bkammer/integrated_sensors_wise_22/README.md

# Integrated Sensors WS2022/23

## Messsystem Spektral-Sensor

Dokumentation: [Messsystem Spektral-Sensor](https://bkammer.github.io/integrated_sensors_wise_22/#/)

## Authors

- Yani Vutov
- Benjamin Kammer
- Dennis Spohrer
