bkammer/integrated_sensors_wise_22/docs/_coverpage.md

<!-- _coverpage.md -->



# Integrated Sensors <small>WS2022/23</small>

> Messsystem Spektral-Sensor

- Yani Vutov
- Benjamin Kammer
- Dennis Spohrer

[GitHub](https://github.com/bkammer/integrated_sensors_wise_22)
[Zur Dokumentation](#Integrated-Sensors)
