bkammer/integrated_sensors_wise_22/docs/_sidebar.md

<!-- files/_sidebar.md -->

* [**Home**](README.md)
* **Projektaufbau 1**
  * [Überblick](files/projektaufbau1.md)
* **Projektaufbau 2**
  * [Überblick](files/projektaufbau2.md)
  * [Stage 1](files/stage1.md)
  * [Stage 2](files/stage2.md)
  * [Stage 3](files/stage3.md)
* [**Offene Aufgaben**](files/offeneAufgaben.md)
* [**Nachwort**](files/nachwort.md)
* [**Quellen**](files/quellen.md)
