bkammer/integrated_sensors_wise_22/docs/files/nachwort.md

# Nachwort

Zusammenfassend, wir sind überzeugt, dass das Projekt ein voller Erfolg geworden ist.
Die selbst gesteckten Ziele konnten übertroffen werden.
Wir haben ein portables Messsystem in handlicher Form hergestellt.
Dieses System ermöglicht es uns, Messdaten von Objekten zu erfassen und diese durch einen Hotspot automatisiert an eine Datenbank in der Cloud zu schicken.
Diese Messdaten, welche das Lichtspektrum der Objekte beinhalten, können für den Benutzer jetzt schon visualisiert dargestellt werden!

Eine Weiterentwicklung des Projektes ist jederzeit möglich.
Es könnte eine automatisierte Analyse der Messdaten erstellt werden welche in ein Aktuatoriksystem zurückgespeist, beispielsweise unreife Bananen von reifen aussortiert.

Wir lernten im Team unsere Stärken zu nutzen und organisierten uns immer besser.
Wir konnten sehr viel über die Funktionsweise des Sensors lernen, als auch wie die Reflektrometrie funktioniert.
Außerdem haben wir neue Tools kennengelernt (z.B. Fusion360 für das Gehäuse, Docsify für die Erstellung von strukturierter Dokumentationen).
Das Arbeiten im Team wie auch das strukturierte, zielorientierte Arbeiten in diesem Projekt wird für unser Berufsleben als Software-Engineer sicherlich hilfreich sein.
