bkammer/integrated_sensors_wise_22/docs/files/offeneAufgaben.md

# Möglichkeiten der Weiterentwicklung

## Spektral-Sensor kalibrieren

Wir haben uns zu Beginn des Projektes überlegt, den Sensor zu mit definierten Farben zu kalibrieren.
Diese wären uns von Professor zur Verfügung gestellt worden, um z.B. zu messen, was "reines Weiß" für ein Spektrum besitzt.
Die gemessenen Daten sollten dann in ein eigenes Dashboard visualisiert werden, um damit z.B. Vergleiche mit anderen Messungen durchzuführen.

## Weitere Messsysteme aufbauen

Wir haben uns auch überlegt weitere Messsysteme aufzubauen, welche nicht innerhalb eines Stempels realisiert werden.
Für die gemessenen Daten müsste im Code eine neuer Tag erstellt werden, um die ESPs voneinander unterscheiden zu können.
Damit könnten die gemessenen Daten zwischen unterschiedlichen Messsystemen verglichen werden

## Eigenschaften ableiten

Eine weitere Möglichkeit wäre es aus den Datensätzen Eigenschaften zu erheben.
Damit könnten dann anschließend Aussagen über neue Messungen getroffen werden.
