bkammer/integrated_sensors_wise_22/docs/meetings/20221018.md

# 18. Oktober 2022

## AS7265x_Fragen_Pargmann

- Wo wird Spektrosopie eingesetzt?
- Brauchen wir Hintergrundwissen zur Spektroskopie?
- Welche Erfahrungen konnte er mit dem Sensor sammeln?
- Zu welchen Einsatzzwecken könnte der Sensor genutzt werden?
- Was ist möglich mit dem Sensor?
- Was kann man mit den 18 Kanälen messen?
- Messaufbau -> was muss beachtet werden? (Keine Lichteinstrahlung von außen?)
- Gibt es Grenzen was die Materialien angeht? (Flüssigkeiten, Gase, Feste Materialien. Messung von nicht hormogenen Materialien)
- Was für weitere Limitierungen hat der Sensor?
- Wie können die Daten interpretiert werden?
- Können mit den Datensätzen vergleiche mit anderen Datenbanken gemacht werden?
- Was für einen einfluss haben Lichtbrechung, Reflexion?
