bkammer/integrated_sensors_wise_22/docs/meetings/20221021.md

# Meeting 21. Oktober 2022

## Topics

- ESP Verbindungsaufbau mit Cloud InfluxDB
- Battery management system (BMS)
- Gehauseidee
- Batteriepower
  - Voltage Regulator
    - [Lipo Rider Plus](https://www.seeedstudio.com/Lipo-Rider-Plus-p-4204.html)
    - [ESP8266 Voltage Regulator](https://randomnerdtutorials.com/esp8266-voltage-regulator-lipo-and-li-ion-batteries/)
  - Build in Systems
    - [Adafruit HUZZAH32 - ESP32 Feather](https://learn.adafruit.com/adafruit-huzzah32-esp32-feather/power-management)
    - [SparkFun ESP32 Thing Plus](https://learn.sparkfun.com/tutorials/esp32-thing-plus-hookup-guide/all#hardware-overview)
    - [FireBeetle ESP32 IoT Microcontroller](https://www.dfrobot.com/product-1590.html)
- Battery
  - [Lithium Ion Battery - 1Ah](https://www.sparkfun.com/products/13813?_ga=2.225162522.1477246465.1666711157-1523142562.1666711157)
  - [Lithium Ion Battery - 1250mAh](https://www.sparkfun.com/products/18286)



## Topics ToDo

- [ ] Dennis: Grafana auf dem RaspberryPi aufsetzen. ESP32: Messung auf Knopfdruck ausfüren.
- [x] Ben: InfluxDB in der Cloud aufsetzen.
- [x] Yani: Einarbeitung in Fusion.
- [x] Marc fuer ESP32 und BMS Fragen.
  - Entweder ein BMS dazu kaufen + Batterie/Akku
  - oder neuen ESP32 mit BMS integriert + Batterie/Akku kaufen
- [x] Berenchen, wie viel Strom die Batterie zieht mit ESP + Sensor
- [ ] ESP in Sleep Modus schalten und per Knopfdruck wieder einschalten
- [ ] Beim Spektralsensor Lichter ausschalten
