bkammer/integrated_sensors_wise_22/docs/meetings/20221025.md

# Meeting 25. Oktober 2022

## Topics

- [x] Erstes Design des Gehäuses steht.
- [x] Datenbank läuft und erste Einrichtung des Nutzers, etc. von Dennis.
- [x] Grobe Rechnung des Stromverbrauches. 120 mA + 80 mA = 200 mA.
  - Batterie mit 800mAh reicht demnach für 4 Stunden.
- [ ] Eine LED als Statusanzeige verwenden, ob der ESP mit der Datenbank verbunden ist.
- Wartlick
  - [ ] Kontaktperson: Prof. König-Birk - Optik
  - [ ] Kontaktperson: Prof. Fittinghoff - Logistik Anwendung

## Topics ToDo

- Dennis: Setup ESP
- Brainstorming welche Materialien für die Messreihe verwendet werden sollen. (Bsp.: Papier)
- Testen von Grafana in der Cloud. (Ben)
- Yani: Anpassung des Gehäuses an den neuen ESP mit Akku
- Datenbank Schema überlegen.
- Prof. König-Birk ansprechen bezüglich Optik
- Prof. Fittinghoff ansprechen bezüglich Logistik Anwendung?

## Gespräch mit Mark

- Testen
  - Können alle Channels in die Datenbank geschickt werden?
  - Können die Daten wieder ausgelesen werden?
- 3D Drucker kann 1mm dicker - Sicherheitshalber auf 2 mm gehen.
- Montag (31.10.) ist Mark da um zu zeigen wie der Harz Drucker funktioniert.
- Proof of Concept abschließen um dann weitere Hardware bestellen zu können.
- Im Programm eine Flag einsetzen um die Debugging ausgabe am PC zu aktivieren/deaktivieren.
- Datenbankstruktur überprüfen lassen (falls andere Materialien gemessen werden sollen).
- Arbeiten mit einer Optik/Linse ist erst ein weiterer Step.
