bkammer/integrated_sensors_wise_22/docs/meetings/20221107.md

# Meeting 7. November 2022

## Topics

- [x] Gehäuse wurde gedruckt
- [x] Messvorgang implementiert

## ToDo

- Button spaming verhindern
- Button bouncing/prellen preventieren?
- Visualisierung der Daten
- Kalibrierung des Sensors
  - Termin mit Prof. Pargmann
