bkammer/integrated_sensors_wise_22/docs/meetings/20221111.md

# Meeting 11. November 2022

## Topics

- InfluxDB
  - [x] Daten persistiert
  - [x] Erstellen der Datenbank mit Environment Variablen
  - [ ] Datenbankschema überlegen
- Grafana
  - [x] Aufsetzen
  - Provisioning
    - [ ] Dashboards
    - [x] Data Sources
-  Messsystem (AS7265x & ESP32)
  - [x] Gehäuse gedruckt
  -  Button
    - [ ] spaming
    - [ ] prellen/bouncing

### Datenbank/Messungen

- Für jedes Objekt ein neues Measurement/Tabelle und Dashboard.
  - Ersteinmal eine Kategorie zum überprüfen des Konzeptes.
- Ein Dashboard für den aktuellen Messwert wo die Farbspektren angezeigt werden.
- Serieller Input für Tags die den Messwerten hinzugefügt werden. (Ohne Störung des Kontrollflusses).

# ToDo

- Dokumetation
  - Absprache mit Mark über die Gestaltung der Dokumentation
- Messsystem
  - Sensor Kalibrieren
    - Termin mit Prof. Pargmann
  - Status LED für die Verbindungsanzeige mit der Datenbank
