bkammer/integrated_sensors_wise_22/docs/meetings/20221114.md

# Meeting 14. November 2022

# Topics

- [x] Tags den Messwerten hinzugefügt
- [x] Batteriemangagementsystem von Mark erhalten

# ToDo
Batteriemanagementsystem
  - Schaltplan erstellen (Fritzing / Muss kein Hardcore Schaltplan sein)
  - Beim Laden soll der ESP vom Netzteil und nicht von der Batterie gespeist werden.
- Dokumentaion
  - lange Erkärungen warum dinge nicht gingen und was die Lösung dafür war.
  - Wie wird I²C bei uns eingesetzt.
  - Über die Zeit wie hat sich dad Projekt geändert. Wie hat es angefangen. Wie sah es in der Mitte aus und wie funktioniert es am Ende.
  - Wie funktioniert der Sensor. Darauf achten nicht das Datenblatt zu kopieren. Eventuell Grafisch darstellen.
  - Wie haben wir es eingesetzt
- Kann man Docsify zu einer PDF generieren.
  - Rückmeldung an Mark
- Syntax highlighting für den Code - Docsify Extension
