bkammer/integrated_sensors_wise_22/docs/meetings/brainstorming.md

# Spektralsensor AS7356x

- Medikamenten Tester
  - Medikamente verändern sich nicht über die Zeit
  - Wie kommt man an die Medikamente
  - Medikamente haben eine kleine Form und passen somit leicht in eine Abgeschlossene Umgebung.

## Anspechpartner

- Prof. König-Birk -> Optik /UV
- Prof. Pospiech -> Sensoren
- Prof. Fittinghoff -> Anwendungen
- Prof. Wartlick
- Michael Dizel?
