bkammer/integrated_sensors_wise_22/docs/files/quellen.md

# Quellen

- [Dokumentation des AS7265X](https://ams.com/documents/20143/36005/AS7265x_DS000612_1-00.pdf/08051c8a-a7f6-6231-7993-2d3fe0bf38b8)

## Bachelor Thesis

- [Github: SpectralSensor](https://github.com/LennardBoediger/SpectralSensor)
- [PDF: Entwicklung und Realisierung einer Messeinrichtung mit den Sensoren AS7261 und AS72651 von ams](https://github.com/LennardBoediger/SpectralSensor/blob/master/Latex/Bachloarbeit.pdf)
