bkammer/integrated_sensors_wise_22/docs/images/Beadboard.jpg

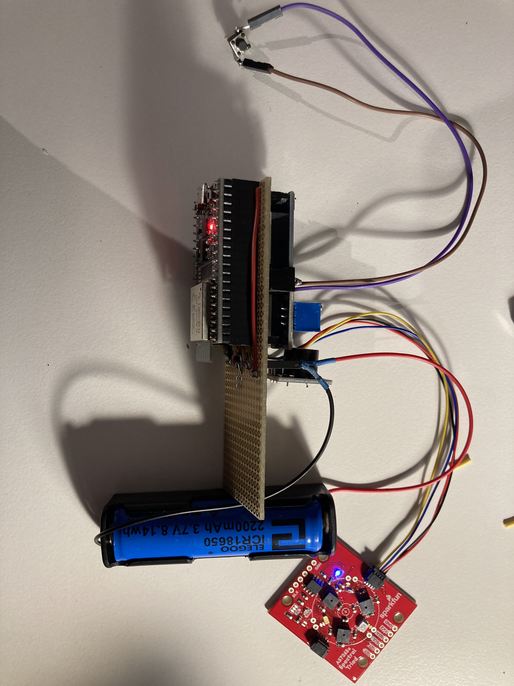
docs/images/Beadboard.jpg
