bkammer/integrated_sensors_wise_22/docs/images/messsystem_split_view_bottom.jpeg

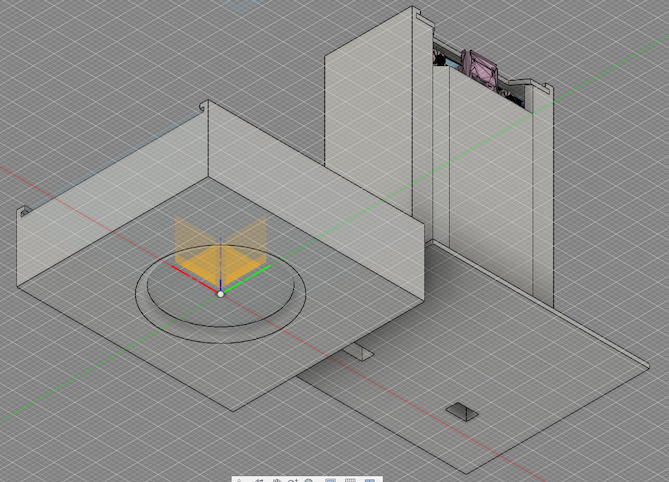
docs/images/messsystem_split_view_bottom.jpeg
