bkammer/integrated_sensors_wise_22/docs/images/messsystem_top_view.jpeg

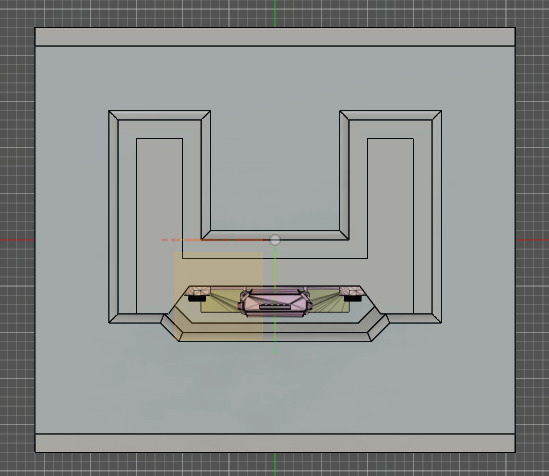
docs/images/messsystem_top_view.jpeg
