bkammer/integrated_sensors_wise_22/docs/images/Messung1.jpg

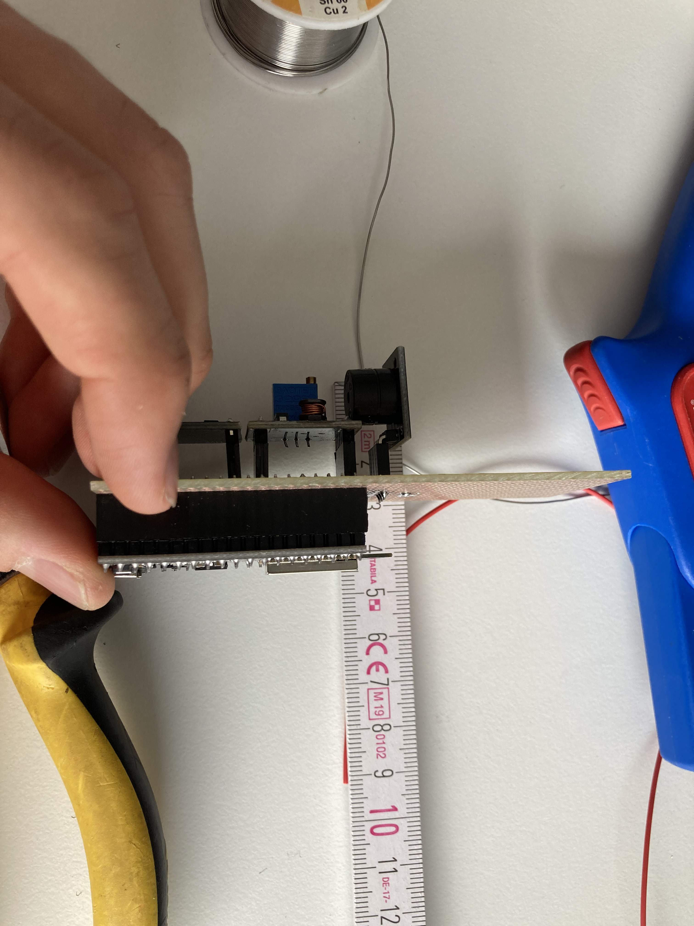
docs/images/Messung1.jpg
