bkammer/integrated_sensors_wise_22/docs/images/Messung2.jpg

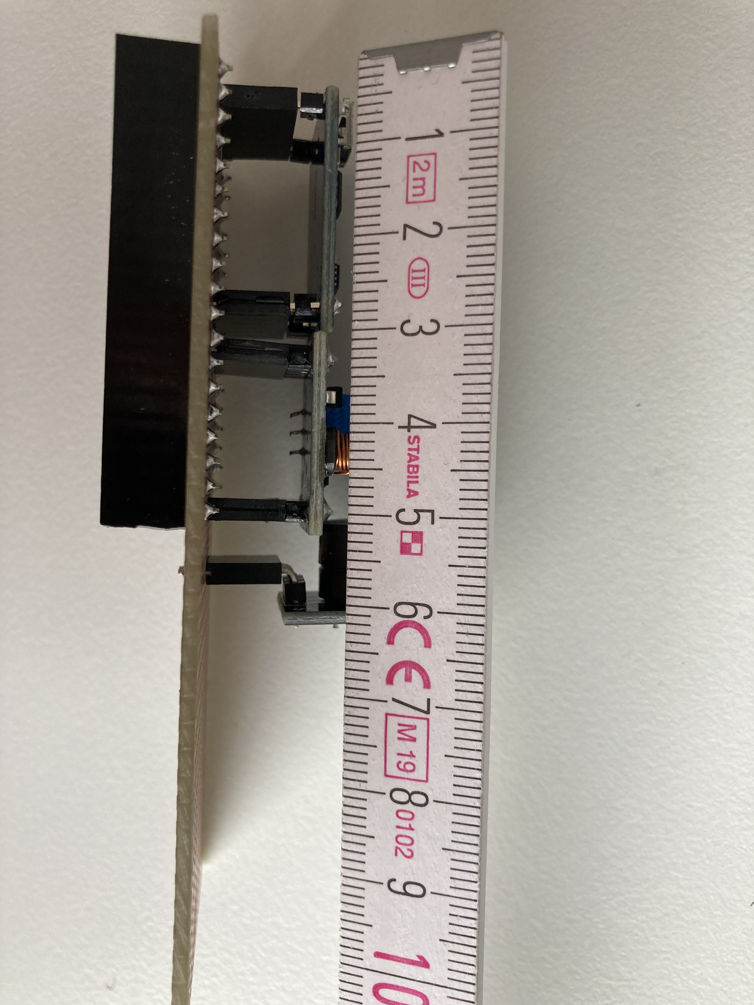
docs/images/Messung2.jpg
