bkammer/integrated_sensors_wise_22/docs/images/Messung3.jpg

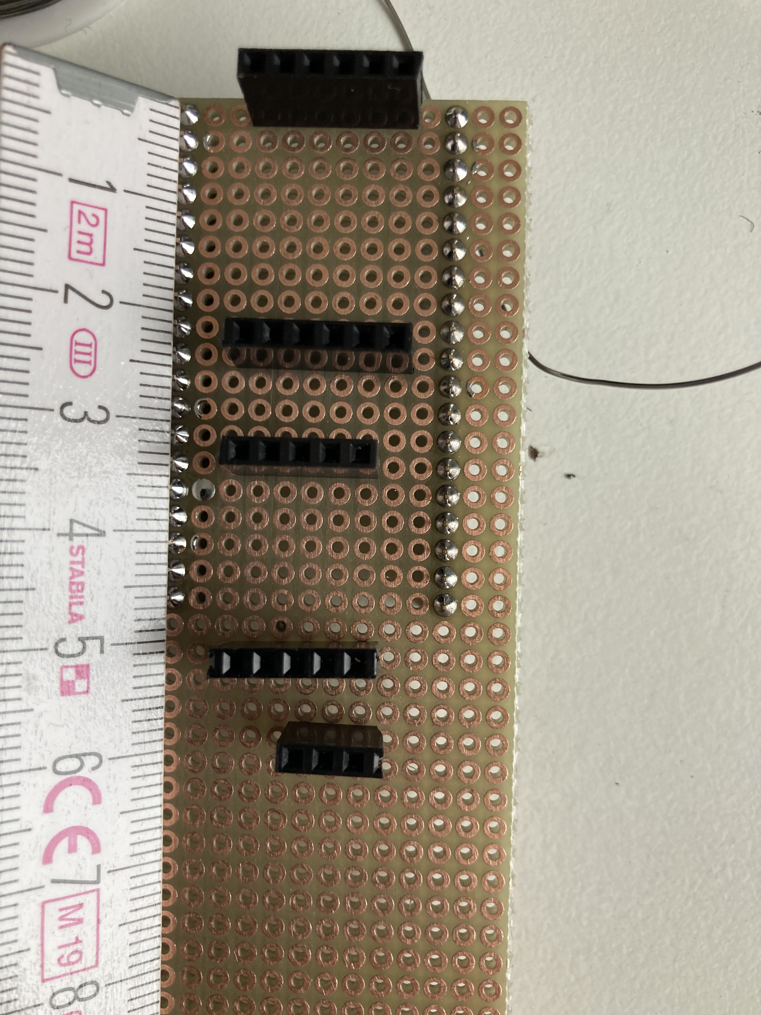
docs/images/Messung3.jpg
