bkammer/integrated_sensors_wise_22/docs/images/v2_messsystem_side_top.JPG

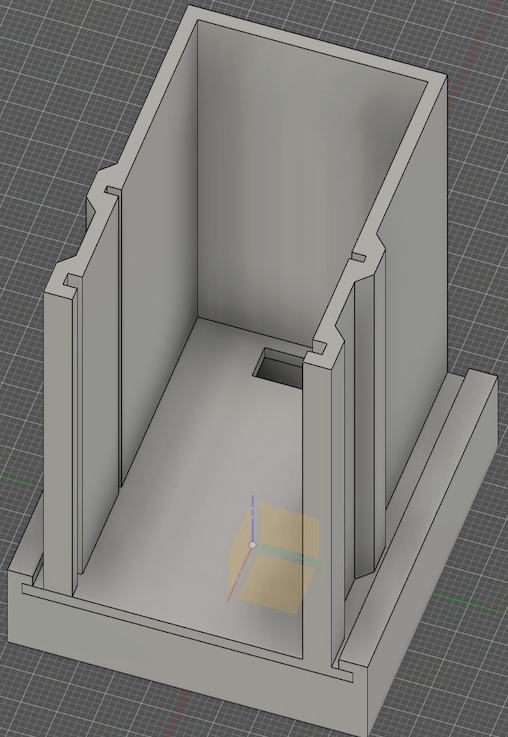
docs/images/v2_messsystem_side_top.JPG
