bkammer/integrated_sensors_wise_22/docs/images/messsystem_printed.jpeg

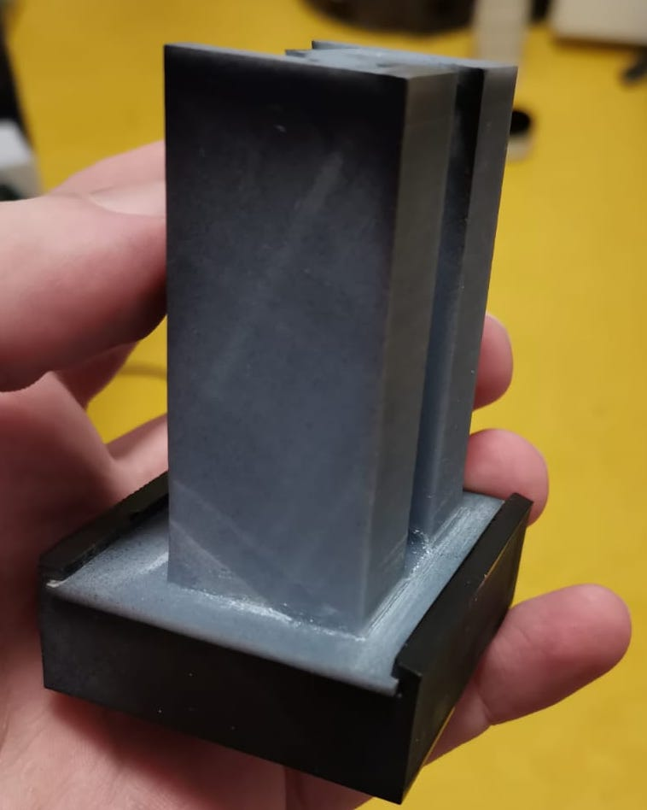
docs/images/messsystem_printed.jpeg
