bkammer/integrated_sensors_wise_22/docs/images/messsystem_printed_bottom.jpeg

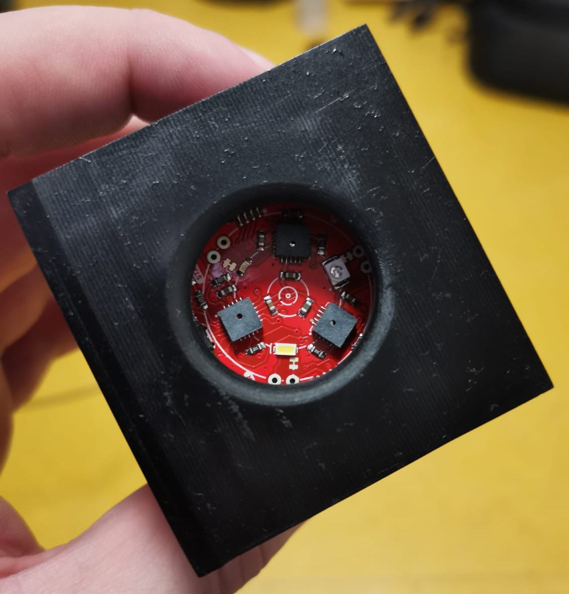
docs/images/messsystem_printed_bottom.jpeg
