bkammer/integrated_sensors_wise_22/docs/images/GF bar chart last measurement panel2.png

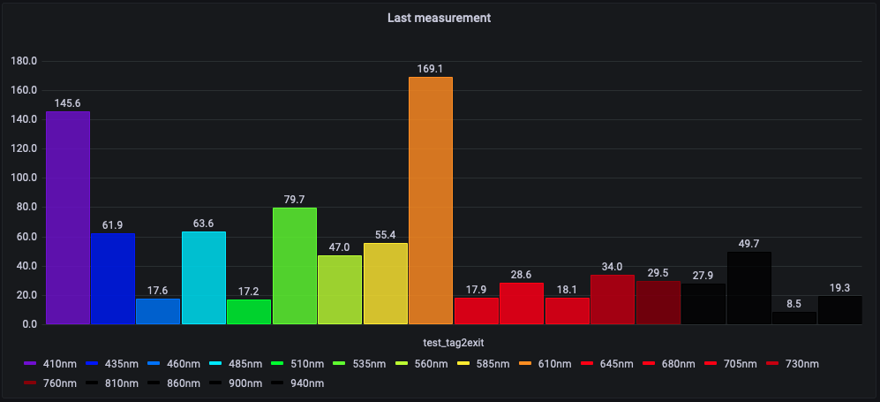
docs/images/GF bar chart last measurement panel2.png
