bkammer/integrated_sensors_wise_22/docs/images/GF bar chart last measurement panel.png

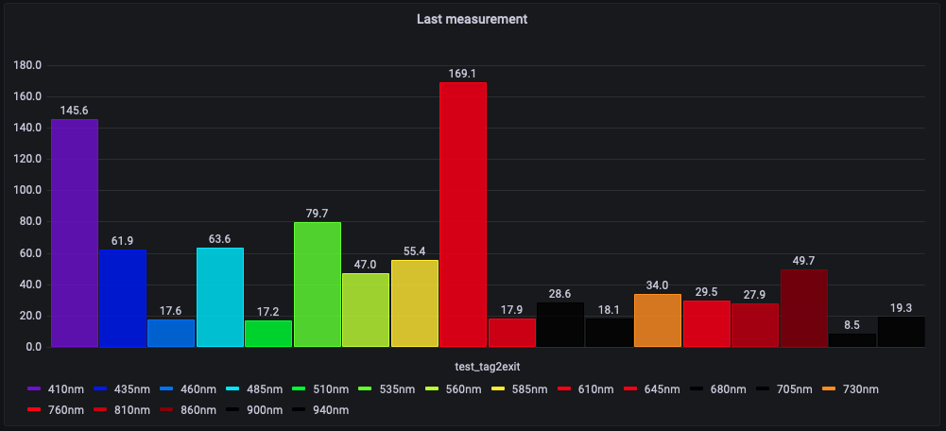
docs/images/GF bar chart last measurement panel.png
