bkammer/integrated_sensors_wise_22/(list of files, drawings)

Other design files:
docs/diagrams/integrated.fzz
