bkammer/integrated_sensors_wise_22/AS7265X/src/Measurements.h

#pragma once

//Function, to take the measurements for debugging
void debugTakeAllMeasurements();

//Function to take all measurements and to send them to the database
void takeSensorData();

//Function to set a new tag for all values stored to the database
void setNewTag();

//Function to set a new measurement, to which the values are stored in
void setNewMeasurement();

void setMeasurementFlag();
