bkammer/integrated_sensors_wise_22/(commit log)

2023-01-12 Moved repository.
    [integrated.fzz]
2023-01-13 Wiring diodes
2023-01-14 Second review of stage3.
