bkammer/integrated_sensors_wise_22/docs/images/SchaltkreisEspSensor.jpg

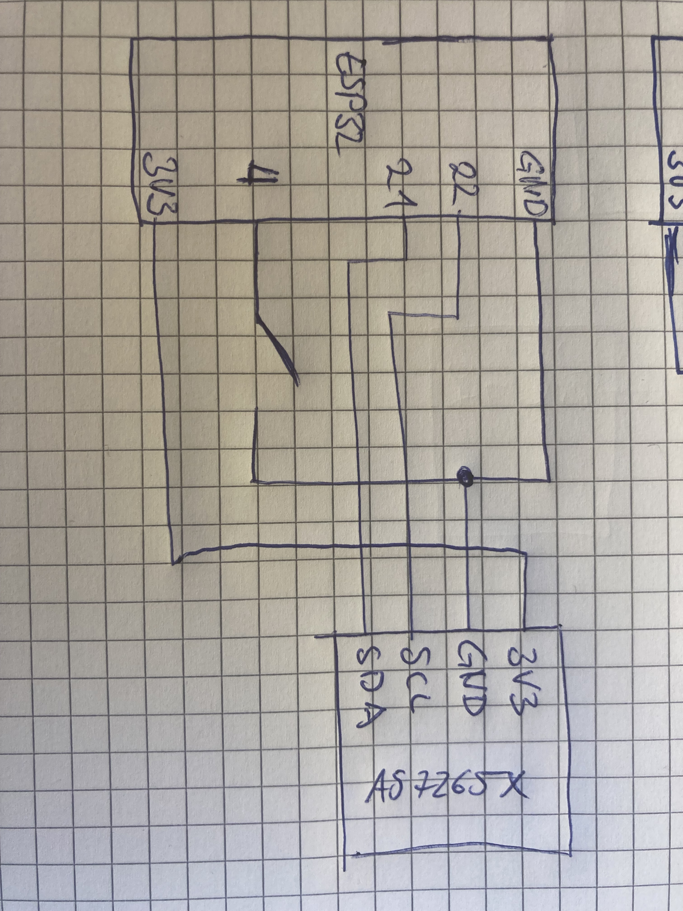
docs/images/SchaltkreisEspSensor.jpg
